Deshan-Lokuge01/IoT-Based-Smart-Irrigation-System-with-Full-System-Controlling/ProtoType_1.jpg

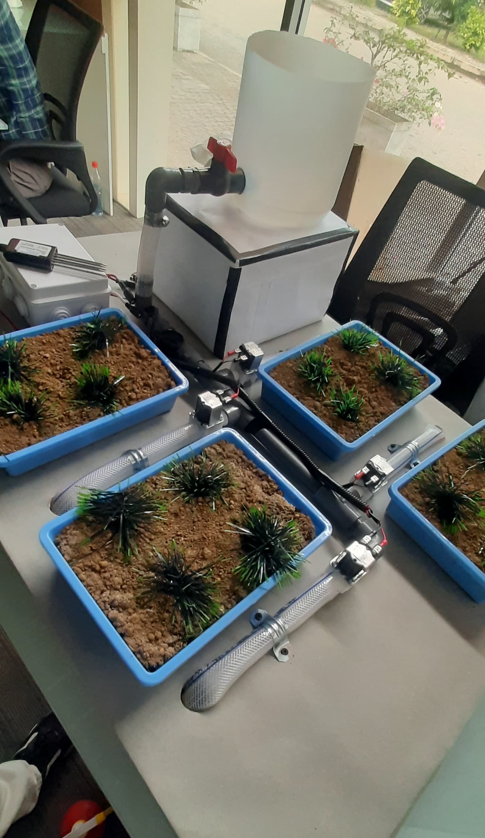
ProtoType_1.jpg
