Deshan-Lokuge01/IoT-Based-Smart-Irrigation-System-with-Full-System-Controlling/System architecture.jpg

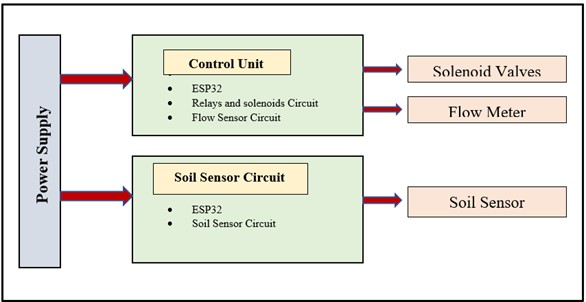
System architecture.jpg
